MattStarfield/power-timer/powerTimerPCB/powerTimer.kicad_pcb

## KiCad design powerTimerPCB/powerTimer.kicad_pcb (2026-04-30)

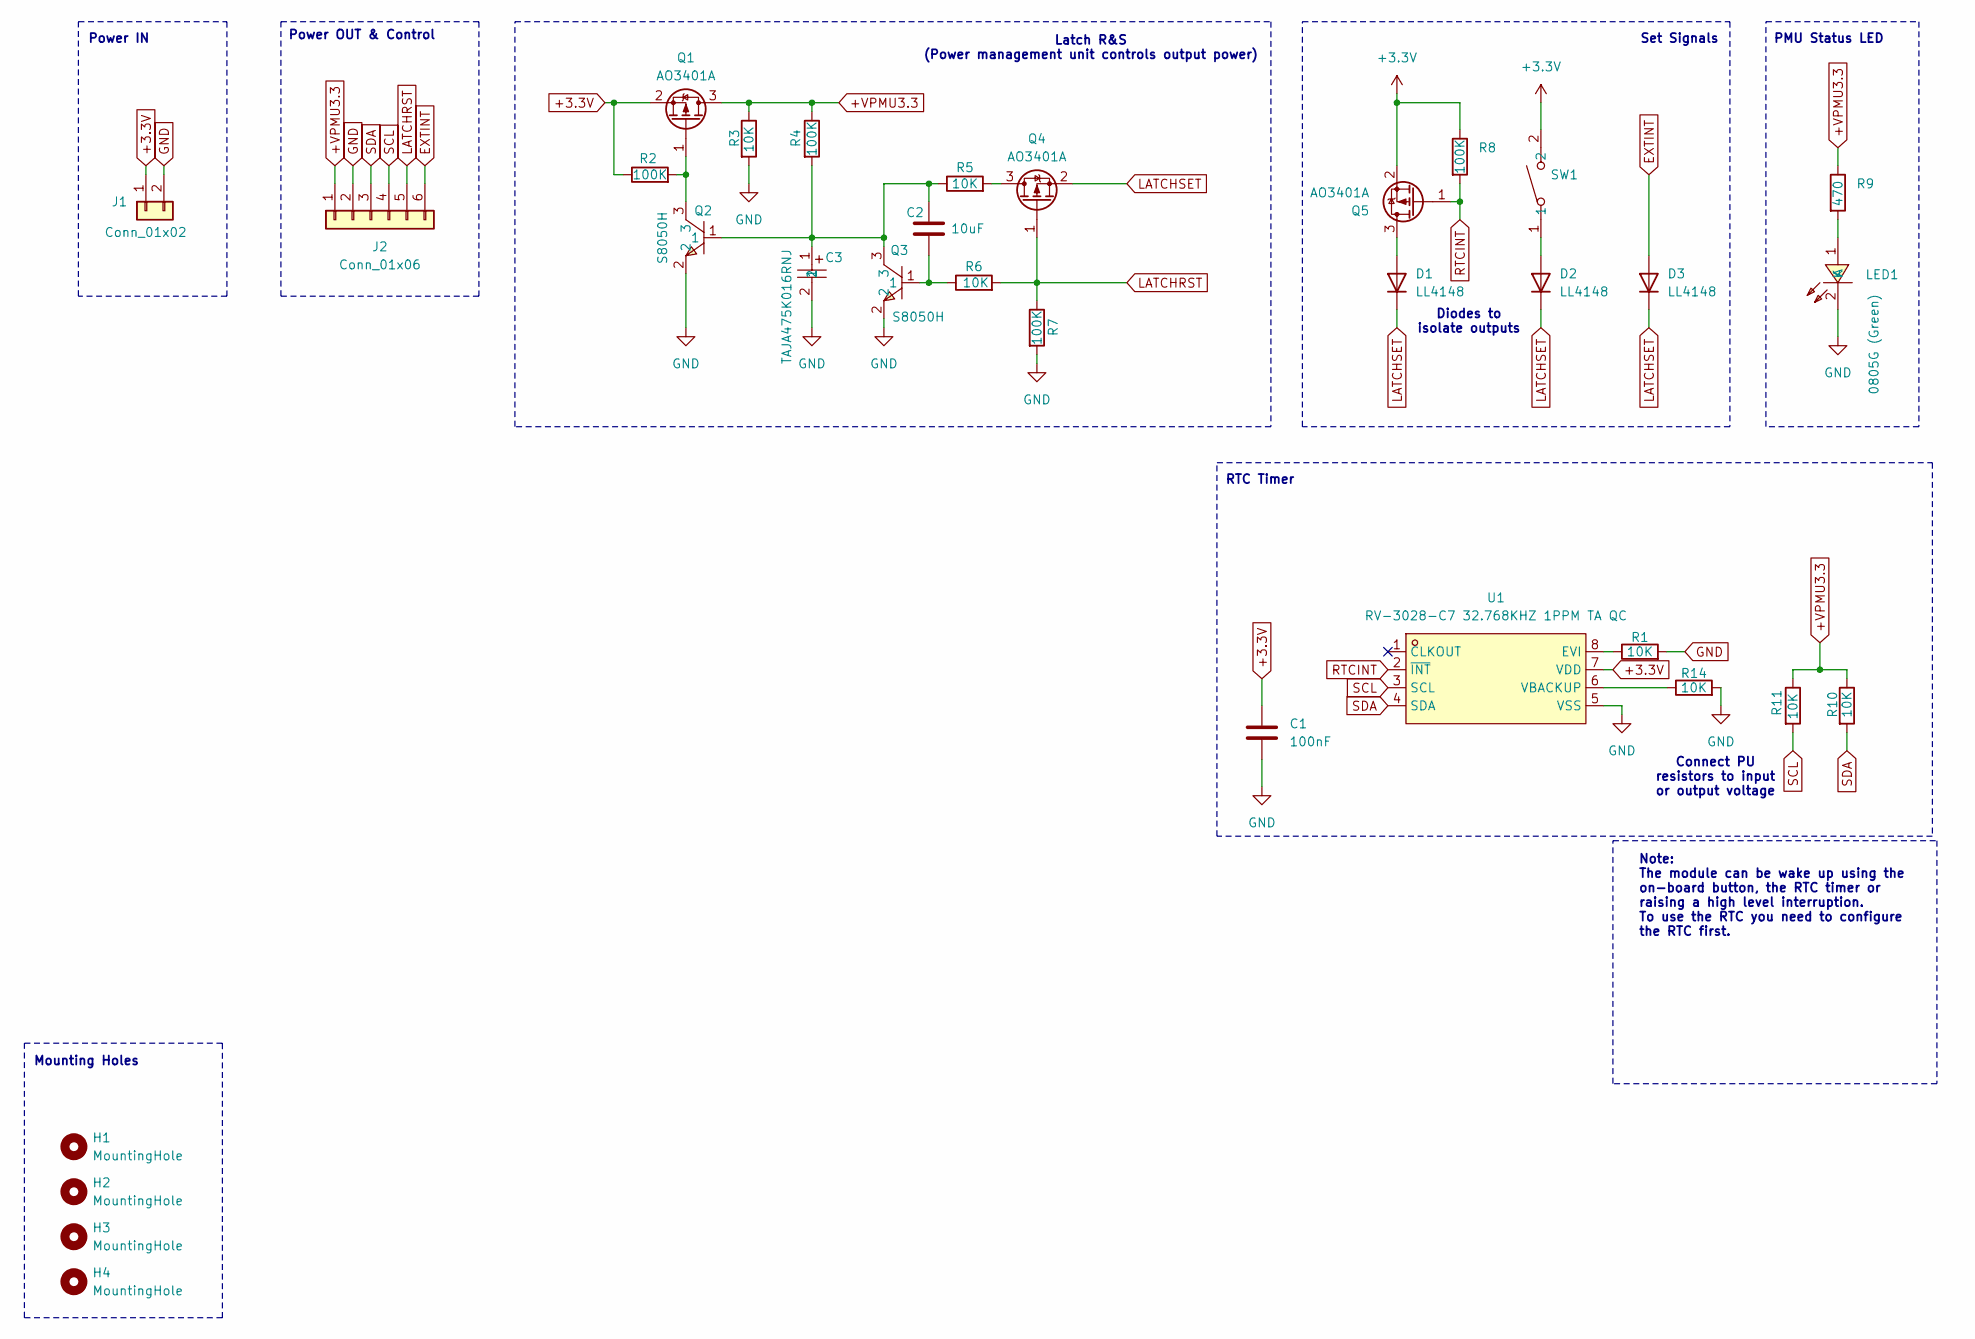
[picture p1: schematic powerTimer.kicad_sch]

Parts:
C1: 100nF; C_0603_1608Metric_Pad1.08x0.95mm_HandSolder; MPN CC0603KRX7R9BB104; LCSC Part C14663
C2: 10uF; C_0603_1608Metric_Pad1.08x0.95mm_HandSolder; MPN CL10A106KP8NNNC; LCSC Part C19702
C3: TAJA475K016RNJ; CASE-A_3216; MPN TAJA475K016RNJ; LCSC Part C7187
D1, D2, D3: LL4148; D_MiniMELF; MPN LL4148; LCSC Part C2857181
H1, H2, H3, H4: MountingHole; MountingHole_2.2mm_M2_ISO7380
J1: Conn_01x02; PinHeader_1x02_P2.54mm_Vertical
J2: Conn_01x06; PinHeader_1x06_P2.54mm_Vertical
LED1: 0805G (Green); LED0805-R-RD; MPN Green LED 0805; LCSC Part C2297
Q1, Q4, Q5: AO3401A; SOT-23; MPN AO3401A; LCSC Part C15127
Q2, Q3: S8050H; SOT-23-3_L2.9-W1.6-P1.90-LS2.8-BR; MPN S8050H; LCSC Part C111272
R1, R3, R5, R6, R10, R11, R14: 10K; R_0603_1608Metric_Pad0.98x0.95mm_HandSolder; MPN 0603WAF1002T5E; LCSC Part C25804
R2, R4, R7, R8: 100K; R_0603_1608Metric_Pad0.98x0.95mm_HandSolder; MPN 0603WAF1003T5E; LCSC Part C25803
R9: 470; R_0603_1608Metric_Pad0.98x0.95mm_HandSolder; MPN 0603WAF4700T5E; LCSC Part C23179
SW1: TS-1185EC-C-D-B; SW-SMD_4P-L3.7-W3.0-P1.50-LS4.7; MPN TS-1185EC-C-D-B; LCSC Part C318893
U1: RV-3028-C7 32.768KHZ 1PPM TA QC; OSC-SMD_8P-L3.2-W1.5-P0.90-BL; MPN RV-3028-C7; LCSC Part C3019759

Connections:
+3.3V: C1.1, J1.1, Q1.2 (S), Q5.2 (S), R2.1, R8.1, SW1.2, U1.7 (VDD)
+VPMU3.3: J2.1, Q1.3 (D), R3.1, R4.1, R9.1, R10.1, R11.1
EXTINT: D3.2 (A), J2.6
GND: C1.2, C3.2, J1.2, J2.2, LED1.2 (K), Q2.2, Q3.2, R1.2, R3.2, R7.2, R14.2, U1.5 (VSS)
LATCHRST: J2.5, Q4.1 (G), R6.2, R7.1
LATCHSET: D1.1 (K), D2.1 (K), D3.1 (K), Q4.2 (S)
unnamed: C2.1, C3.1, Q2.1, Q3.3, R4.2, R5.1
unnamed: C2.2, Q3.1, R6.1
unnamed: D1.2 (A), Q5.3 (D)
unnamed: D2.2 (A), SW1.1
unnamed: LED1.1 (A), R9.2
unnamed: Q1.1 (G), Q2.3, R2.2
unnamed: Q4.3 (D), R5.2
unnamed: R1.1, U1.8 (EVI)
unnamed: R14.1, U1.6 (VBACKUP)
RTCINT: Q5.1 (G), R8.2, U1.2 (~INT)
SCL: J2.4, R11.2, U1.3 (SCL)
SDA: J2.3, R10.2, U1.4 (SDA)

Notes on the sheet:
RTC Timer
Latch R&S (Power management unit controls output power)
Note: The module can be wake up using the on-board button, the RTC timer or raising a high level interruption. To use the RTC you need to configure the RTC first.
Power OUT & Control
Set Signals
PMU Status LED
Power IN
Mounting Holes
Diodes to isolate outputs
Connect PU resistors to input or output voltage

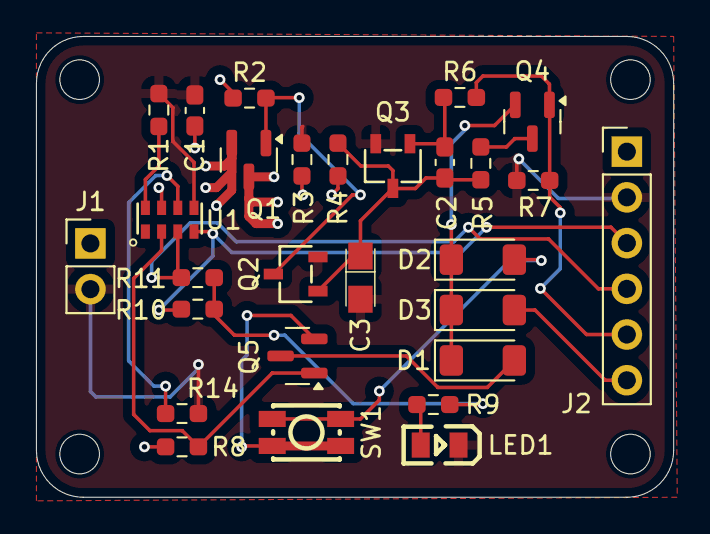
[picture p2: board powerTimer.kicad_pcb from above]

Board: 2 copper layers, 35.4 x 25.6 mm, 32 parts (0 on the bottom side), 18 nets.
